Celeautech-Lab/color-pulse/CAD/STEP/color_pulse_asm.stp

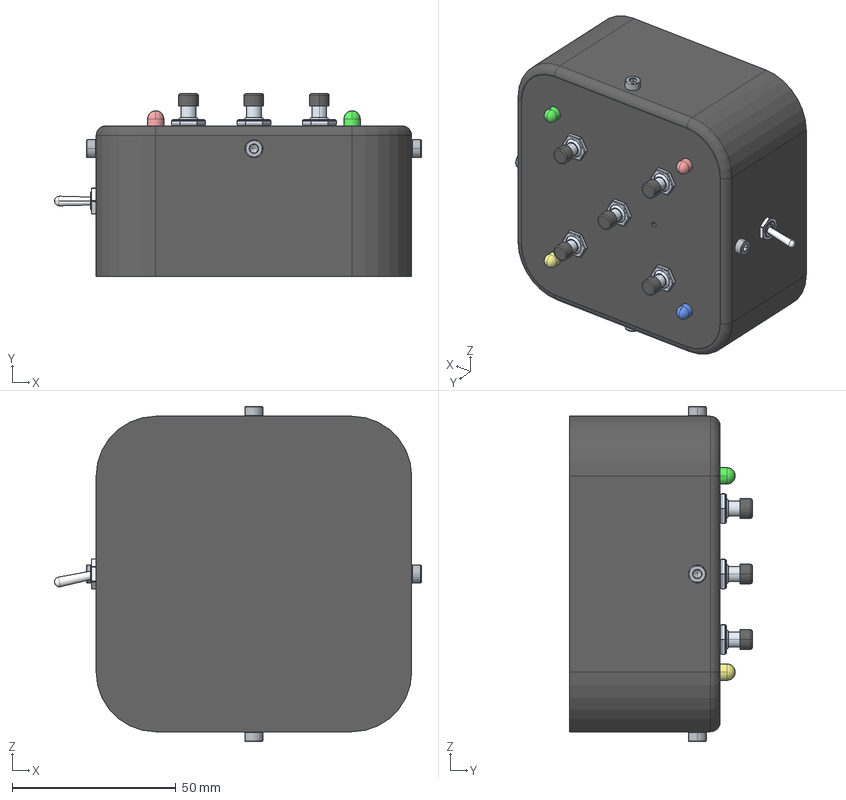
[picture p7: CAD file, 2026-10-21]
CAD/STEP/color_pulse_asm.stp
112.1 x 55.8 x 102.4 mm
TOP
5MM_LED_RED
5MM_LED_GREEN
5MM_LED_YELLOW
5MM_LED_BLUE
PUSH_BUTTON_NUT x 5
ACTIVE_BUZZER
M3_NUT x 4
M3X12_SCREW003 x 4
BATERY
PCB_6DC
J1_USB_MINI-B_LUMBERG_2486_01_H
R1_R_0603_1608METRIC_5F4AD58B
D1_LED_0603_1608METRIC_5F4AD4A1
U1_TQFP_32_7X7MM_P08MM_5F4B89F1
SW1_SW_SPST_CK_RS282G05A3_5F4B9
D2_LED_0603_1608METRIC_5F4BB16E
D3_LED_0603_1608METRIC_5F4BB181
D4_LED_0603_1608METRIC_5F4BB194
R2_R_0603_1608METRIC_5F4BB207
R3_R_0603_1608METRIC_5F4BB218
R4_R_0603_1608METRIC_5F4BB229
Y1_MURATA_CSTXEXXV_5F4BB25D
D5_D_0805_5F4AD4B4
U2_SOP_16_44X104MM_P127MM_5F4C8
C1_C_0603_1608METRIC_5F4BB0F2
C2_C_0603_1608METRIC_5F4BB0F3
C4_C_0603_1608METRIC_5F4BB124
C5_C_0603_1608METRIC_5F4BB135
J2_PINHEADER_1X15_P254MM_VERTIC
J3_PINHEADER_1X15_P254MM_VERTIC
R5_R_0603_1608METRIC_5F4BB23A
R6_R_0603_1608METRIC_5F4BB24B
R7_R_0603_1608METRIC_5F4BB25C
Y2_MURATA_CSTXEXXV_5F4BB293
C6_CP_EIA_3216_18_KEMET_A_5F4BF
C7_CP_EIA_3216_18_KEMET_A_5F4BF
U3_SOT_89_3_5F4BFB48
METAL_PART_1
METAL_PART_2
POLYAMIDE_BODY
TERMINAL x 3
NUT_B x 2
