Celeautech-Lab/color-pulse/CAD/3MF/top.3mf

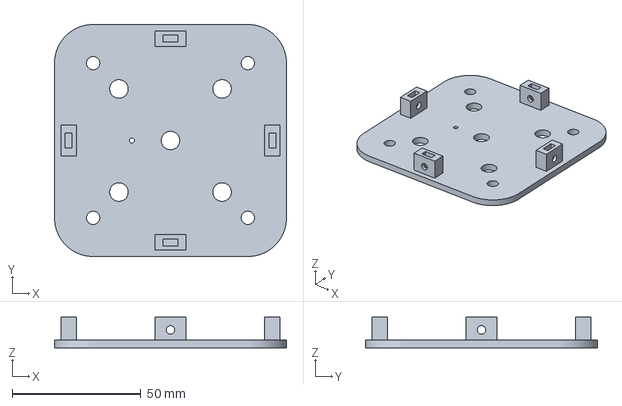
[picture p8: CAD file, 2026-10-21]
CAD/3MF/top.3mf
90.0 x 90.0 x 12.0 mm
