Celeautech-Lab/color-pulse/CAD/3MF/box.3mf

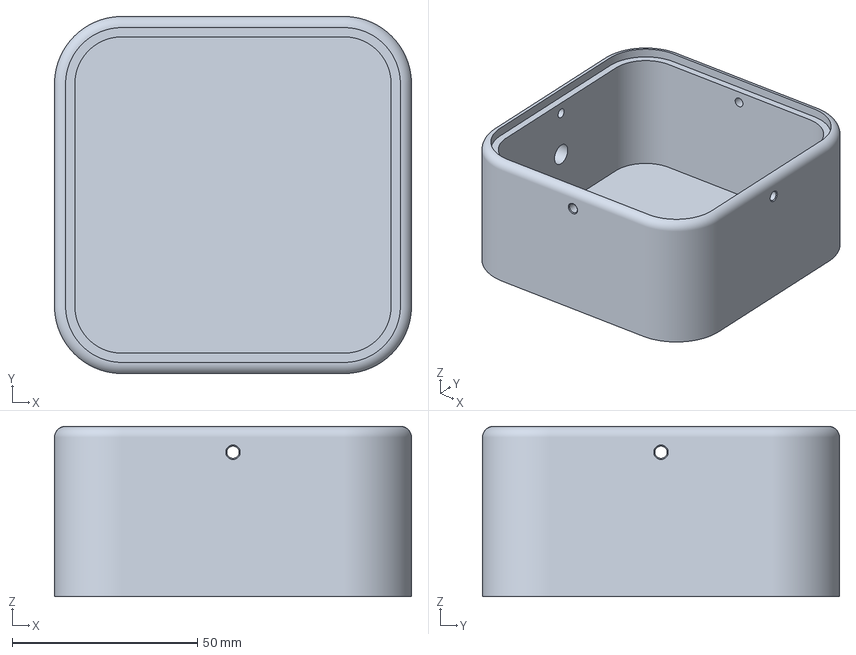
[picture p9: CAD file, 2026-10-21]
CAD/3MF/box.3mf
96.4 x 96.4 x 46.0 mm
