Celeautech-Lab/color-pulse/(commit log)

2026-10-21 added assembly STEP file and arduino code
    [color_pulse_asm.stp]
2026-10-21 Updated step file and added 3MF files
    [box.3mf, color_pulse_asm.stp, top.3mf]
2026-10-21 Create Bill of Materials for project components
    Added a detailed Bill of Materials (BOM) including electronics, hardware, 3D-printed parts, and required tools for the project.
2026-10-21 Revise BOM.md for component details and wiring
    Updated component references and specifications in BOM.md for clarity and accuracy.
2026-10-21 Update pushbutton description in BOM.md
2026-10-21 Correct pushbutton pin assignments in BOM
    Updated pin assignments for pushbuttons in BOM.
2026-10-21 Enhance README with project details and instructions
    Added detailed project description, specifications, and assembly instructions for the Color Pulse game.
